aravindjayan/CamRover/camRover_pcb/camRover_pcb_v1_1/camRover_pcb_v1_1.kicad_pcb

## KiCad design camRover_pcb/camRover_pcb_v1_1/camRover_pcb_v1_1.kicad_pcb (2026-10-27)

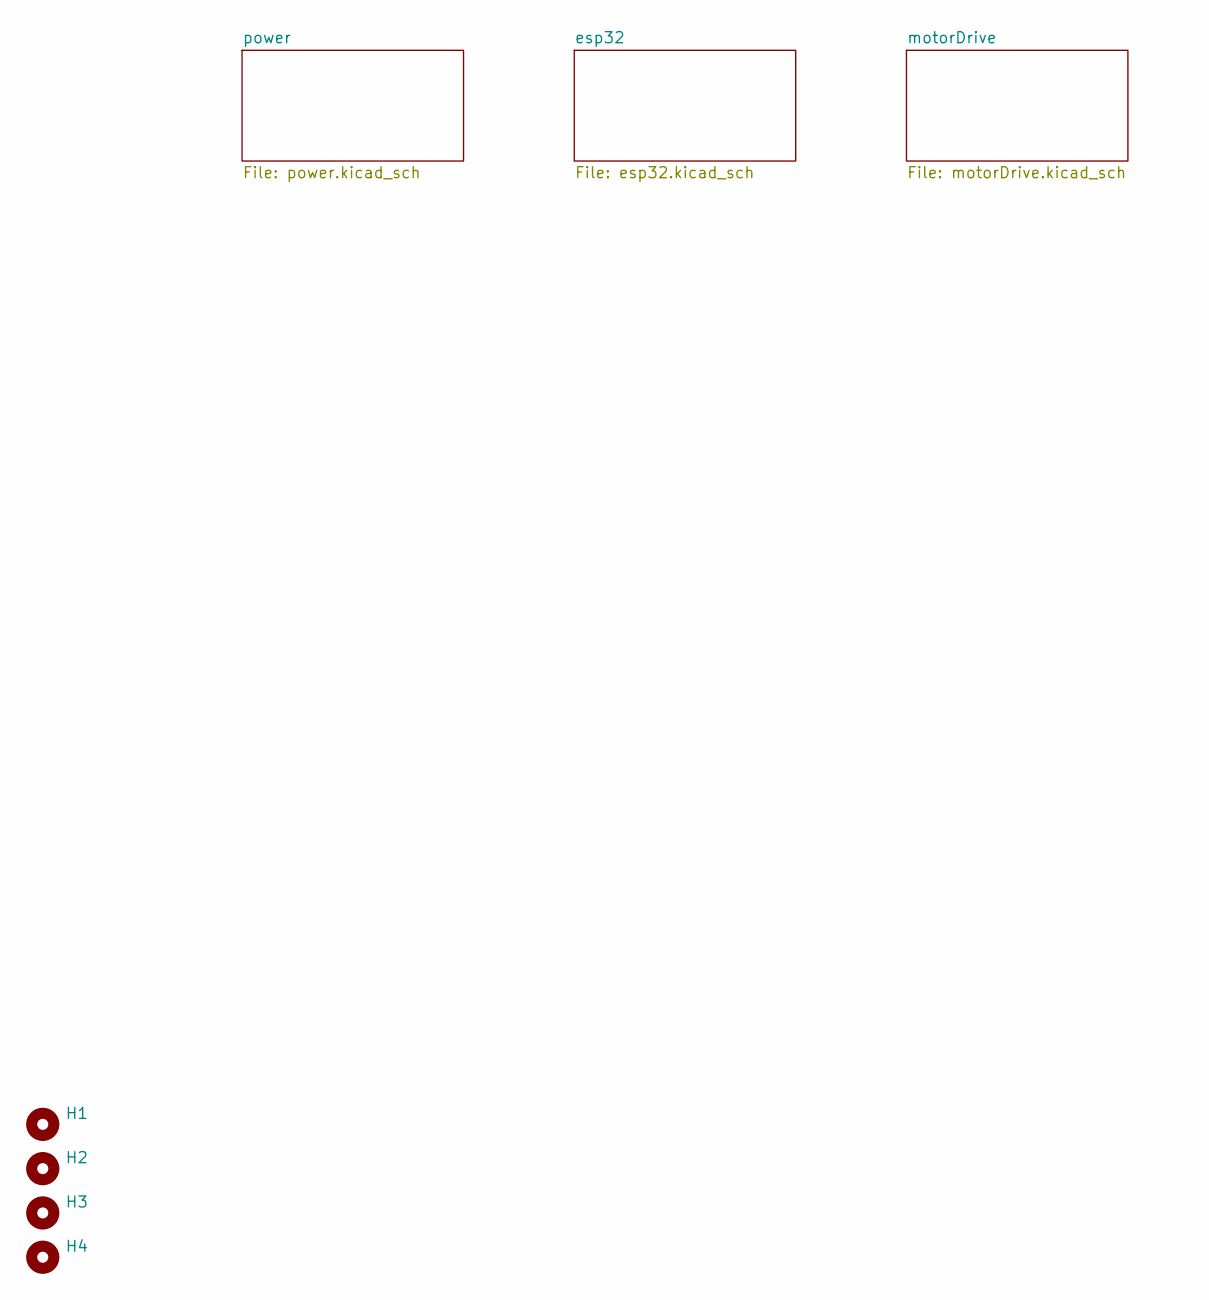
[picture p6: schematic camRover_pcb_v1_1.kicad_sch, camRover v1.1]

Parts:
H1, H2, H3, H4: MountingHole; MountingHole_3.2mm_M3

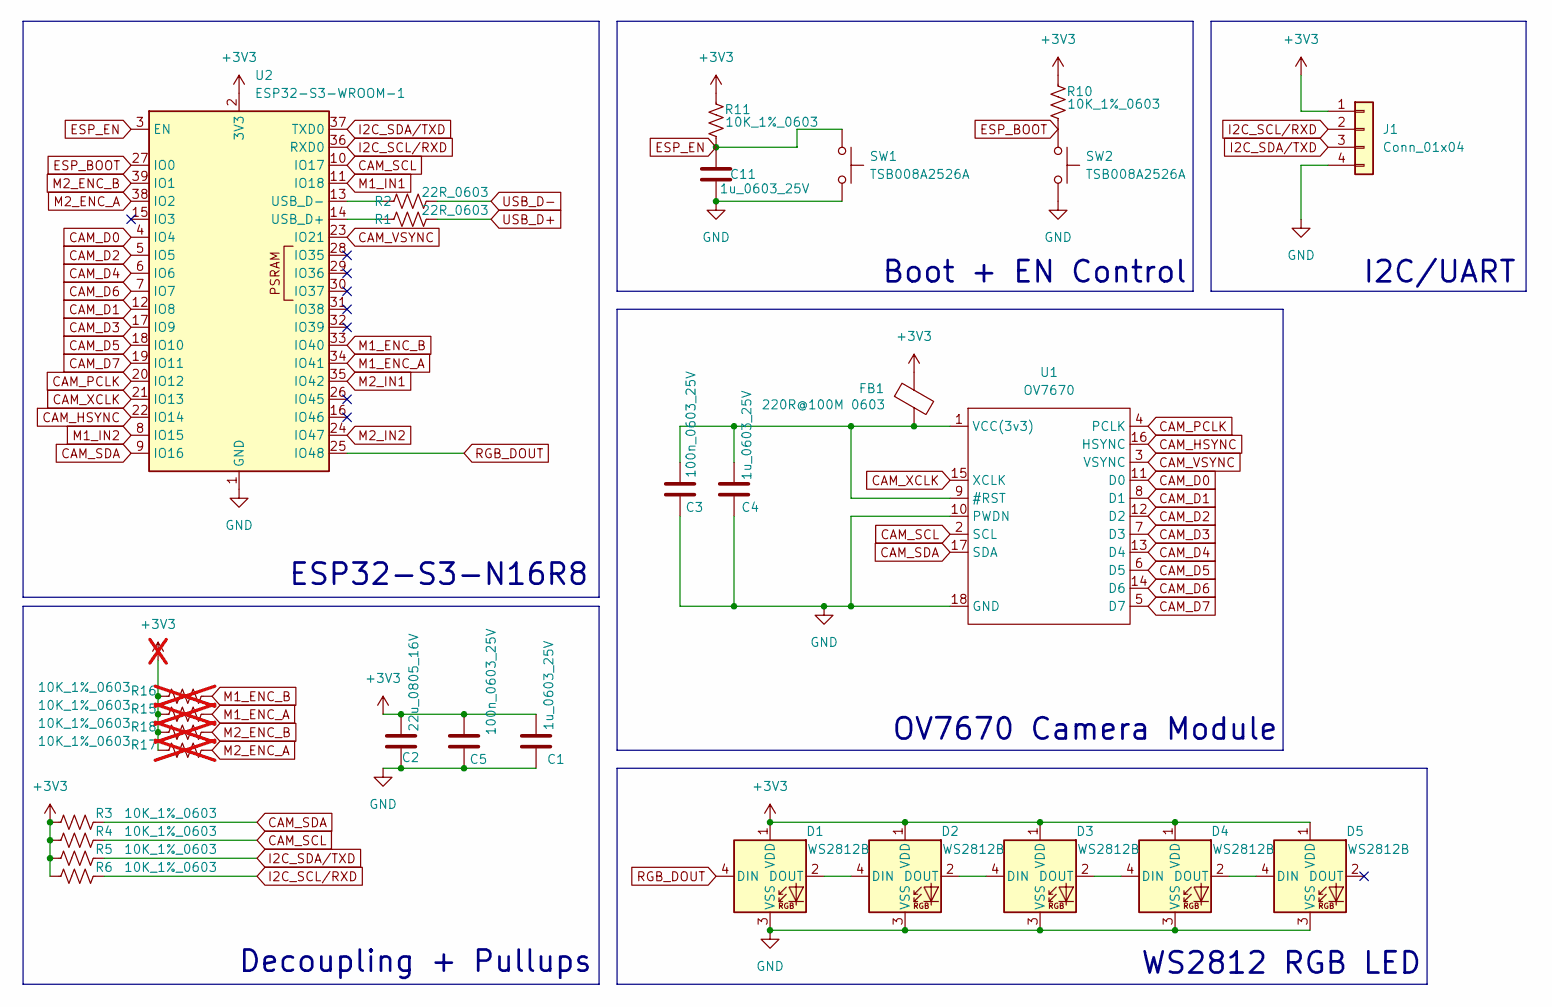
[picture p7: schematic esp32.kicad_sch, camRover v1.1]

Parts:
C1, C4, C11: 1u_0603_25V; C_0603_1608Metric
C2: 22u_0805_16V; C_0805_2012Metric
C3, C5: 100n_0603_25V; C_0603_1608Metric
D1, D2, D3, D4, D5: WS2812B; LED_WS2812B_PLCC4_5.0x5.0mm_P3.2mm
FB1: 220R@100M 0603; L_0603_1608Metric
J1: Conn_01x04; PinHeader_1x04_P2.54mm_Vertical
R1, R2: 22R_0603; R_0603_1608Metric
R3, R4, R5, R6, R10, R11: 10K_1%_0603; R_0603_1608Metric
R15, R16, R17, R18: 10K_1%_0603; R_0603_1608Metric; not fitted
SW1, SW2: TSB008A2526A; SW_SPST_CK_RS282G05A3
U1: OV7670; ov7670_dipModule
U2: ESP32-S3-WROOM-1

Connections:
+3V3: C1.1, C2.2, C5.1, D1.1 (VDD), D2.1 (VDD), D3.1 (VDD), D4.1 (VDD), D5.1 (VDD), FB1.1, J1.1, R3.2, R4.2, R5.2, R6.2, R10.1, R11.1, R15.2, R16.2, R17.2, R18.2, U2.2 (3V3); also elsewhere on the board
CAM_D0: U1.11 (D0), U2.4 (IO4)
CAM_D1: U1.8 (D1), U2.12 (IO8)
CAM_D2: U1.12 (D2), U2.5 (IO5)
CAM_D3: U1.7 (D3), U2.17 (IO9)
CAM_D4: U1.13 (D4), U2.6 (IO6)
CAM_D5: U1.6 (D5), U2.18 (IO10)
CAM_D6: U1.14 (D6), U2.7 (IO7)
CAM_D7: U1.5 (D7), U2.19 (IO11)
CAM_HSYNC: U1.16 (HSYNC), U2.22 (IO14)
CAM_PCLK: U1.4 (PCLK), U2.20 (IO12)
CAM_SCL: R4.1, U1.2 (SCL), U2.10 (IO17)
CAM_SDA: R3.1, U1.17 (SDA), U2.9 (IO16)
CAM_VSYNC: U1.3 (VSYNC), U2.23 (IO21)
CAM_XCLK: U1.15 (XCLK), U2.21 (IO13)
ESP_BOOT: R10.2, SW2.1, U2.27 (IO0)
ESP_EN: C11.1, R11.2, SW1.1, U2.3 (EN)
GND: C1.2, C2.1, C3.2, C4.2, C5.2, C11.2, D1.3 (VSS), D2.3 (VSS), D3.3 (VSS), D4.3 (VSS), D5.3 (VSS), J1.4, SW1.2, SW2.2, U1.10 (PWDN), U1.18 (GND), U2.1 (GND), U2.40 (GND), U2.41 (GND); also elsewhere on the board
I2C_SCL/RXD: J1.2, R6.1, U2.36 (RXD0)
I2C_SDA/TXD: J1.3, R5.1, U2.37 (TXD0)
M1_ENC_A: R15.1, U2.34 (IO41); also elsewhere on the board
M1_ENC_B: R16.1, U2.33 (IO40); also elsewhere on the board
M1_IN1: U2.11 (IO18); also elsewhere on the board
M1_IN2: U2.8 (IO15); also elsewhere on the board
M2_ENC_A: R17.1, U2.38 (IO2); also elsewhere on the board
M2_ENC_B: R18.1, U2.39 (IO1); also elsewhere on the board
M2_IN1: U2.35 (IO42); also elsewhere on the board
M2_IN2: U2.24 (IO47); also elsewhere on the board
unnamed: D1.2 (DOUT), D2.4 (DIN)
unnamed: D2.2 (DOUT), D3.4 (DIN)
unnamed: D3.2 (DOUT), D4.4 (DIN)
unnamed: D4.2 (DOUT), D5.4 (DIN)
unnamed: C3.1, C4.1, FB1.2, U1.1 (VCC(3v3)), U1.9 (#RST)
unnamed: R1.1, U2.14 (USB_D+)
unnamed: R2.1, U2.13 (USB_D-)
RGB_DOUT: D1.4 (DIN), U2.25 (IO48)
USB_D+: R1.2; also elsewhere on the board
USB_D-: R2.2; also elsewhere on the board

Notes on the sheet:
I2C/UART
OV7670 Camera Module
Decoupling + Pullups
ESP32-S3-N16R8
WS2812 RGB LED
Boot + EN Control

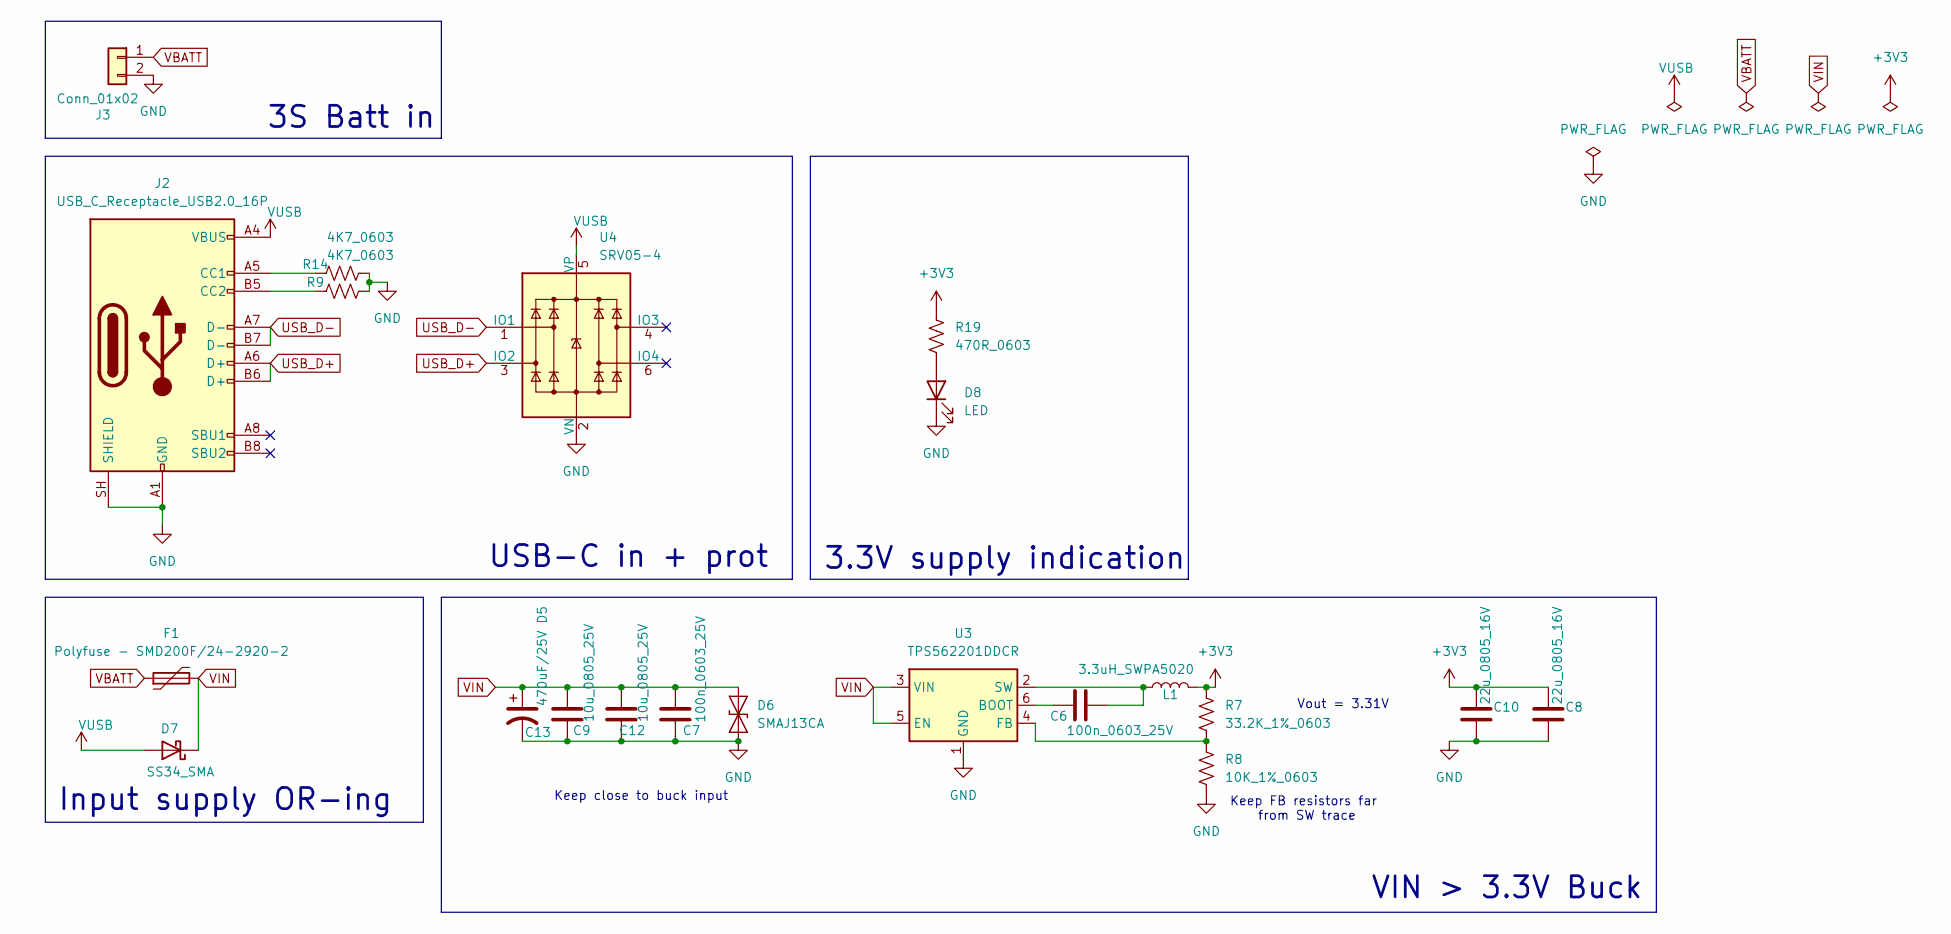
[picture p8: schematic power.kicad_sch, camRover v1.1]

Parts:
C6, C7: 100n_0603_25V; C_0603_1608Metric
C8, C10: 22u_0805_16V; C_0805_2012Metric
C9, C12: 10u_0805_25V; C_0805_2012Metric
C13: 470uF/25V D5; CP_Radial_D6.3mm_P2.50mm
D6: SMAJ13CA; D_SMA
D7: SS34_SMA; D_SMA
D8: LED; LED_0805_2012Metric
F1: Polyfuse - SMD200F/24-2920-2; Fuse_2920_7451Metric
J2: USB_C_Receptacle_USB2.0_16P; USB_C_Receptacle_U263-163N-4WS1735-XKB
J3: Conn_01x02; SolderWire-1.5sqmm_1x02_P7.8mm_D1.7mm_OD3.9mm
L1: 3.3uH_SWPA5020; L_Sunlord_SWPA5020S
R7: 33.2K_1%_0603; R_0603_1608Metric
R8: 10K_1%_0603; R_0603_1608Metric
R9, R14: 4K7_0603; R_0603_1608Metric
R19: 470R_0603; R_0603_1608Metric
U3: TPS562201DDCR; SOT-23-6
U4: SRV05-4; SOT-23-6

Connections:
+3V3: C8.2, C10.2, L1.2, R7.2, R19.2; also elsewhere on the board
GND: C7.2, C8.1, C9.2, C10.1, C12.2, C13.2, D6.1 (A1), D8.1 (K), J2.A1 (GND), J2.A12 (GND), J2.B1 (GND), J2.B12 (GND), J2.SH (SHIELD), J3.2, R8.1, R9.2, R14.2, U3.1 (GND), U4.2 (VN); also elsewhere on the board
unnamed: D8.2 (A), R19.1
unnamed: J2.A5 (CC1), R14.1
unnamed: J2.B5 (CC2), R9.1
unnamed: C6.1, U3.6 (BOOT)
unnamed: R7.1, R8.2, U3.4 (FB)
unnamed: C6.2, L1.1, U3.2 (SW)
USB_D+: J2.A6 (D+), J2.B6 (D+), U4.3 (IO2); also elsewhere on the board
USB_D-: J2.A7 (D-), J2.B7 (D-), U4.1 (IO1); also elsewhere on the board
VBATT: F1.1, J3.1
VIN: C7.1, C9.1, C12.1, C13.1, D6.2 (A2), D7.1 (K), F1.2, U3.3 (VIN), U3.5 (EN); also elsewhere on the board
VUSB: D7.2 (A), J2.A4 (VBUS), J2.A9 (VBUS), J2.B4 (VBUS), J2.B9 (VBUS), U4.5 (VP)

Notes on the sheet:
3S Batt in
Keep close to buck input
VIN > 3.3V Buck
Vout = 3.31V
USB-C in + prot
Keep FB resistors far from SW trace
Input supply OR-ing
3.3V supply indication

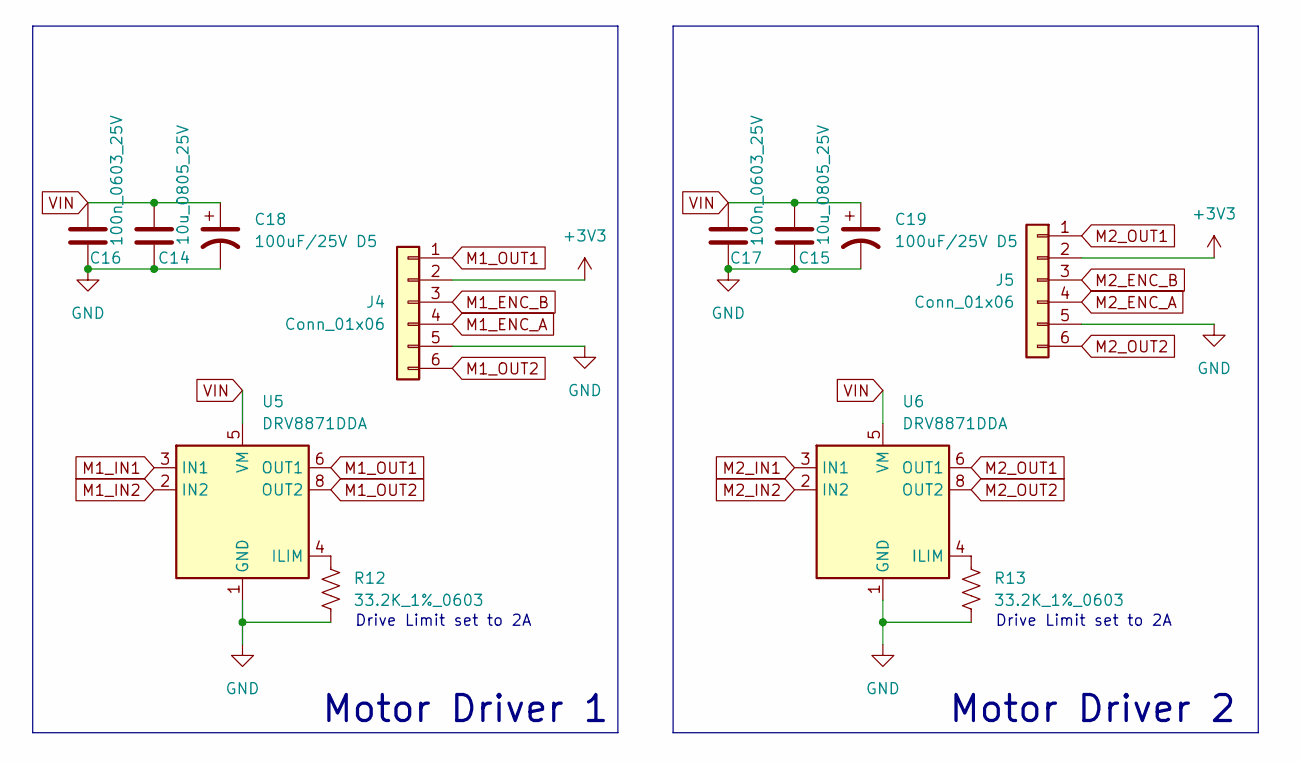
[picture p9: schematic motorDrive.kicad_sch, camRover v1.1]

Parts:
C14, C15: 10u_0805_25V; C_0805_2012Metric
C16, C17: 100n_0603_25V; C_0603_1608Metric
C18, C19: 100uF/25V D5; CP_Radial_D5.0mm_P2.00mm
J4, J5: Conn_01x06; 6pin_wireConn_2.54p
R12, R13: 33.2K_1%_0603; R_0603_1608Metric
U5, U6: DRV8871DDA; Texas_HTSOP-8-1EP_3.9x4.9mm_P1.27mm_EP2.95x4.9mm_Mask2.4x3.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

Connections:
+3V3: J4.2, J5.2; also elsewhere on the board
GND: C14.2, C15.2, C16.2, C17.2, C18.2, C19.2, J4.5, J5.5, R12.1, R13.1, U5.1 (GND), U5.7 (GND), U5.9 (GND), U6.1 (GND), U6.7 (GND), U6.9 (GND); also elsewhere on the board
M1_ENC_A: J4.4; also elsewhere on the board
M1_ENC_B: J4.3; also elsewhere on the board
M1_IN1: U5.3 (IN1); also elsewhere on the board
M1_IN2: U5.2 (IN2); also elsewhere on the board
M1_OUT1: J4.1, U5.6 (OUT1)
M1_OUT2: J4.6, U5.8 (OUT2)
M2_ENC_A: J5.4; also elsewhere on the board
M2_ENC_B: J5.3; also elsewhere on the board
M2_IN1: U6.3 (IN1); also elsewhere on the board
M2_IN2: U6.2 (IN2); also elsewhere on the board
M2_OUT1: J5.1, U6.6 (OUT1)
M2_OUT2: J5.6, U6.8 (OUT2)
unnamed: R12.2, U5.4 (ILIM)
unnamed: R13.2, U6.4 (ILIM)
VIN: C14.1, C15.1, C16.1, C17.1, C18.1, C19.1, U5.5 (VM), U6.5 (VM); also elsewhere on the board

Notes on the sheet:
Drive Limit set to 2A
Motor Driver 2
Motor Driver 1

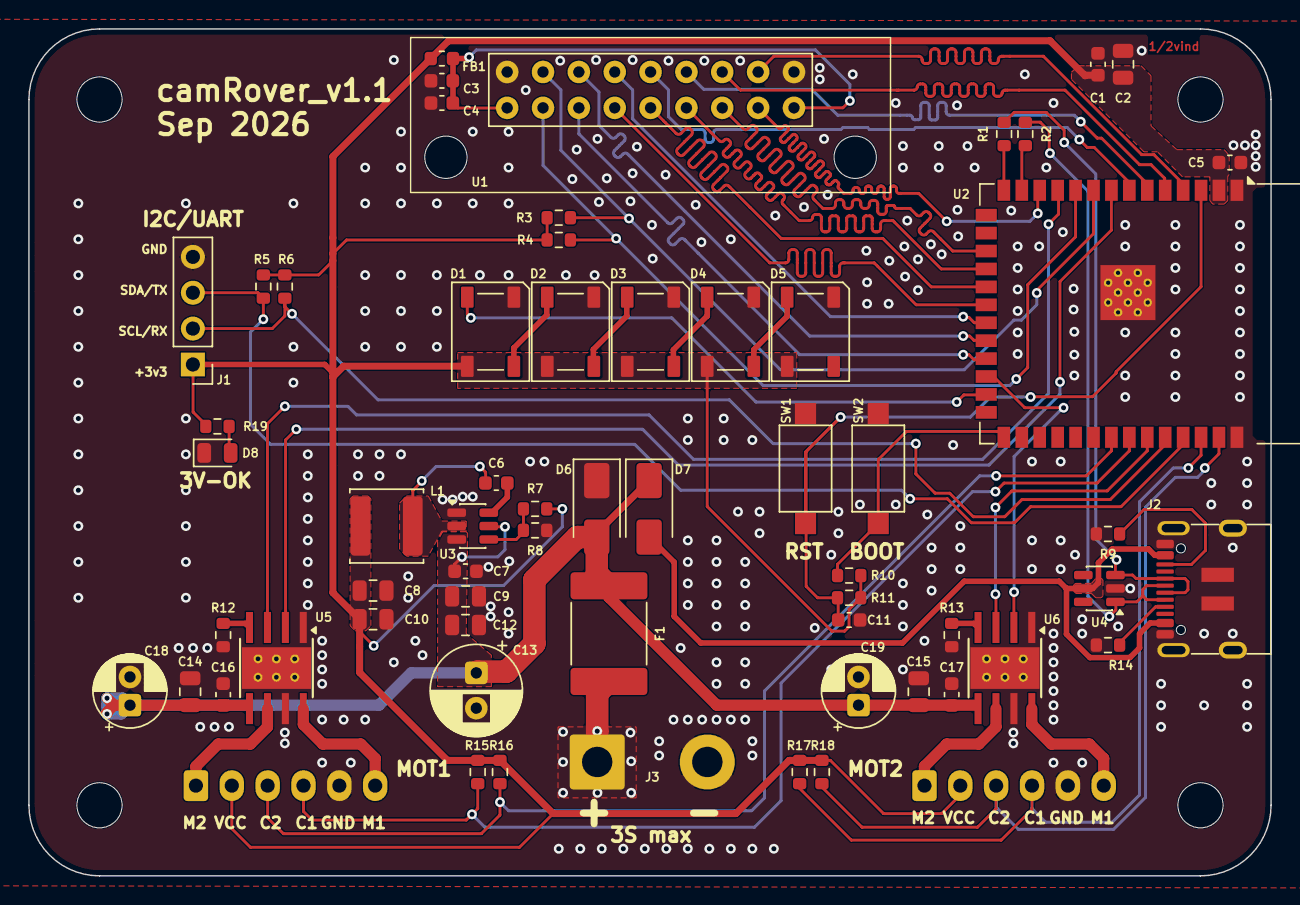
[picture p10: board camRover_pcb_v1_1.kicad_pcb from above]

Board: 2 copper layers, 88.0 x 60.0 mm, 66 parts (0 on the bottom side), 53 nets.
